Blake-Robotics/PiUPS/hardware/RPi_Hat.png

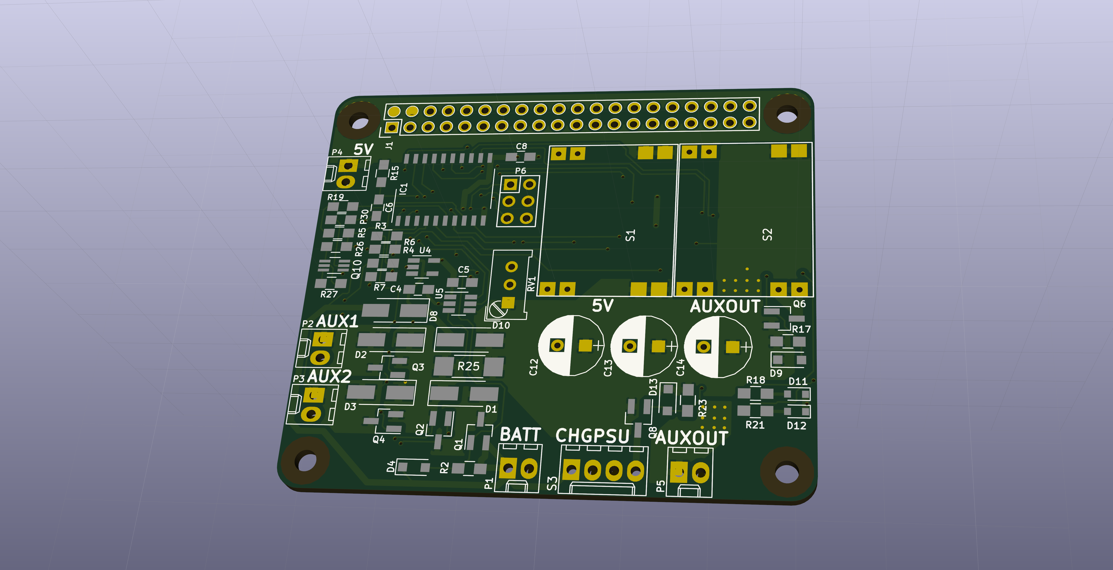
hardware/RPi_Hat.png
