Blake-Robotics/PiUPS/README.md

# PiUPS
Project to manage the power supply for the electronics of the robot. A microcontroller is used to monitor the state of the battery and external power inputs.
