Blake-Robotics/PiUPS/hardware/RPi_Hat.pdf

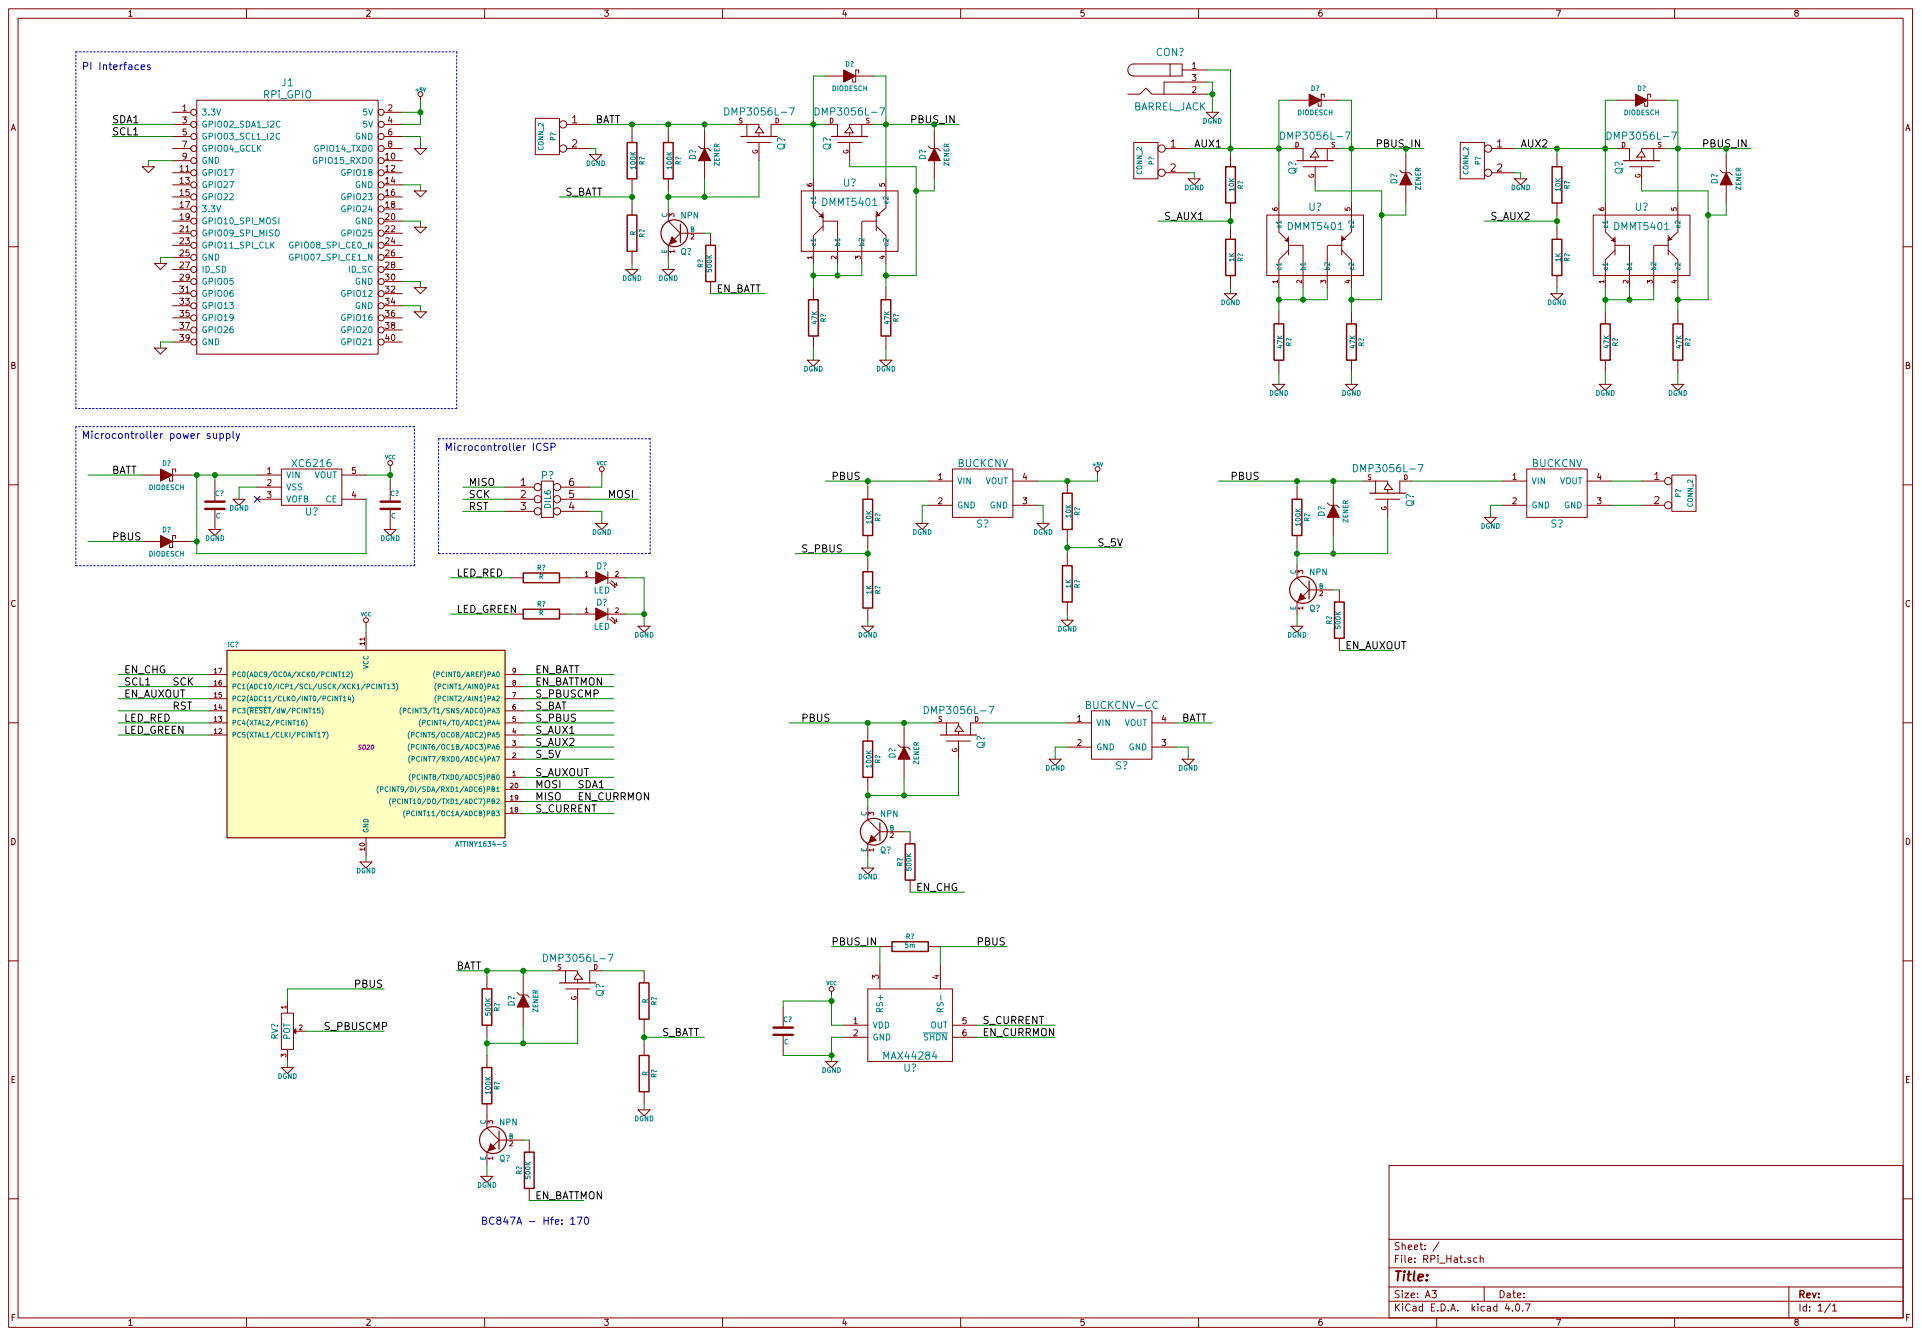
[picture p2: page 1]
