Blake-Robotics/PiUPS/hardware/RPi_Hat.kicad_pcb

## KiCad design hardware/RPi_Hat.kicad_pcb (2018-01-17)

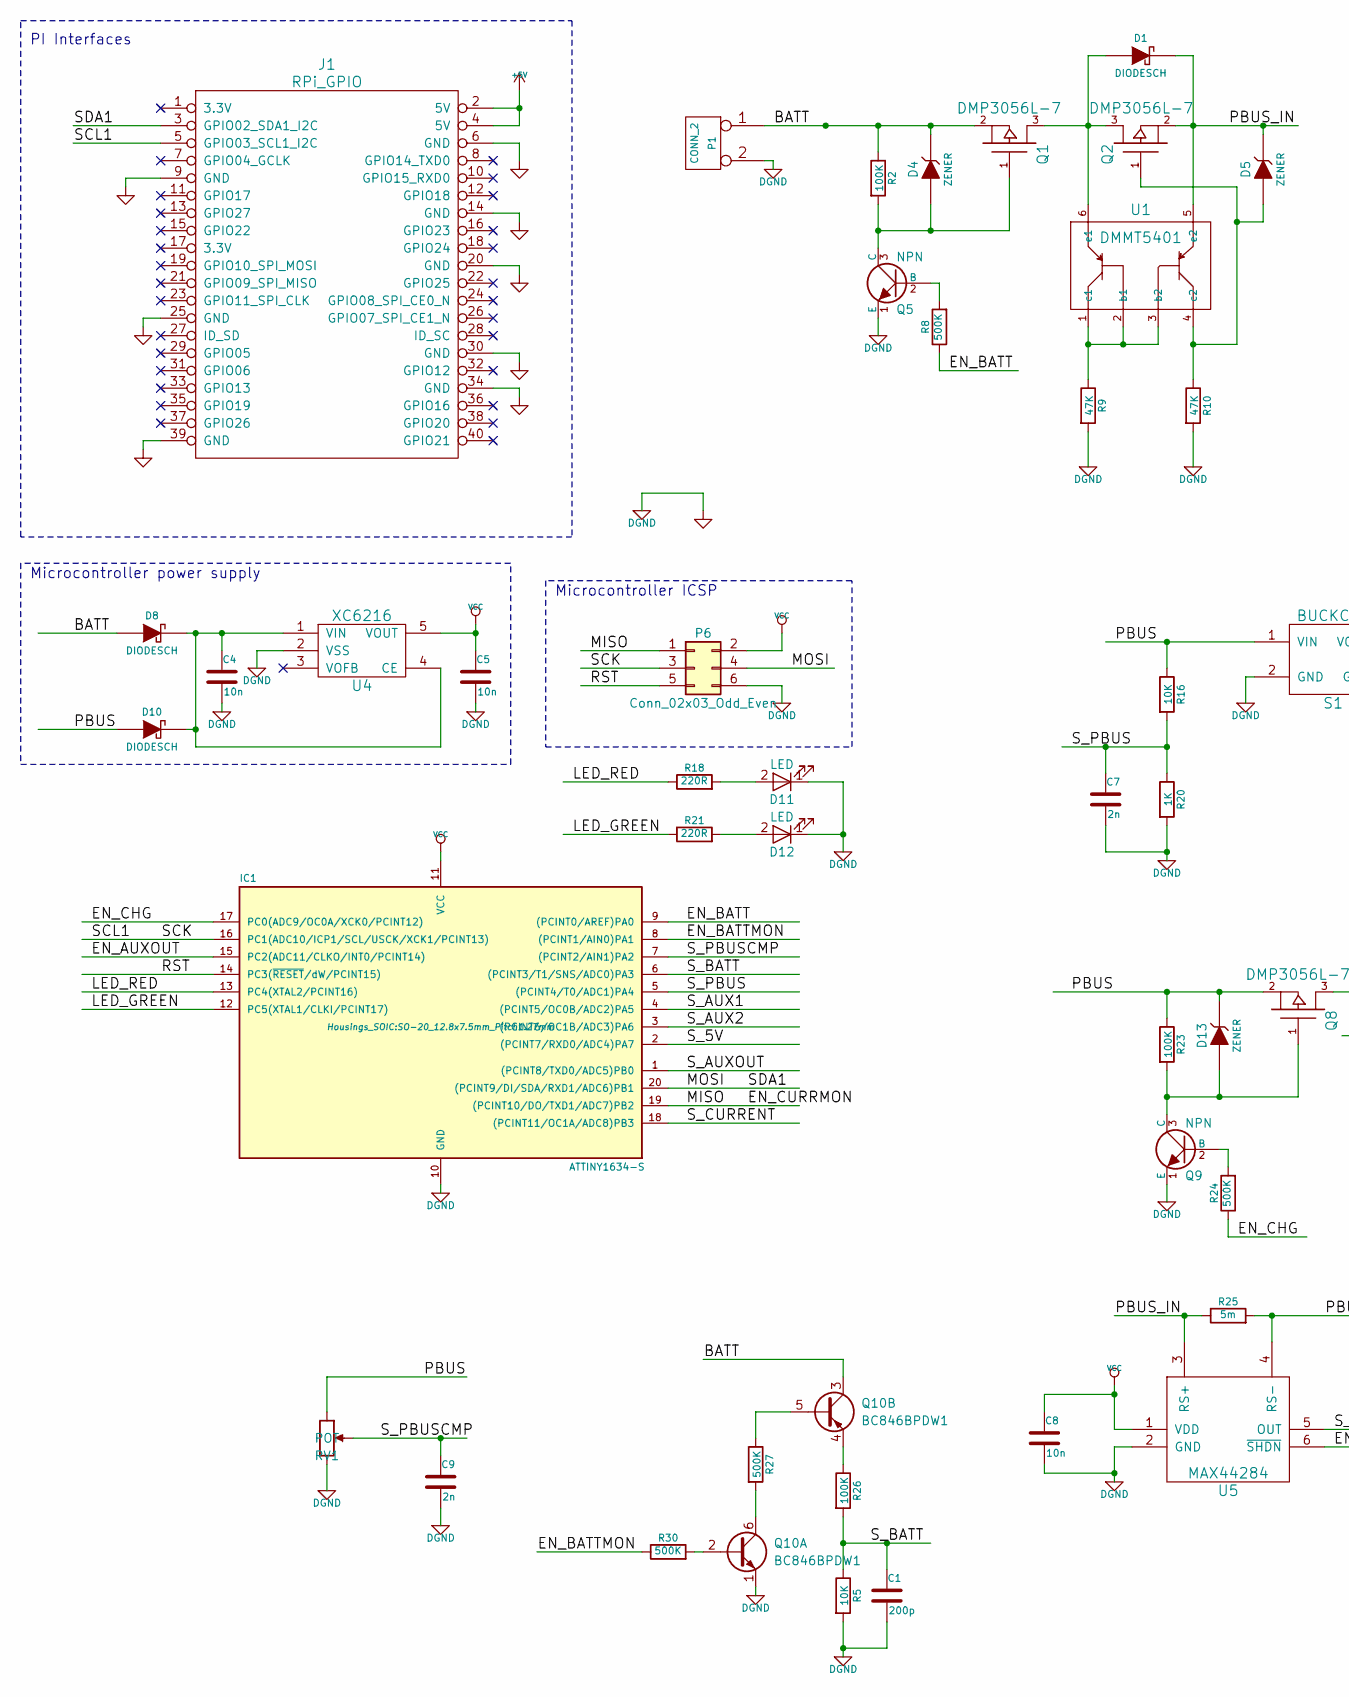
[picture p3: schematic RPi_Hat.sch, part in row 1, column 1]

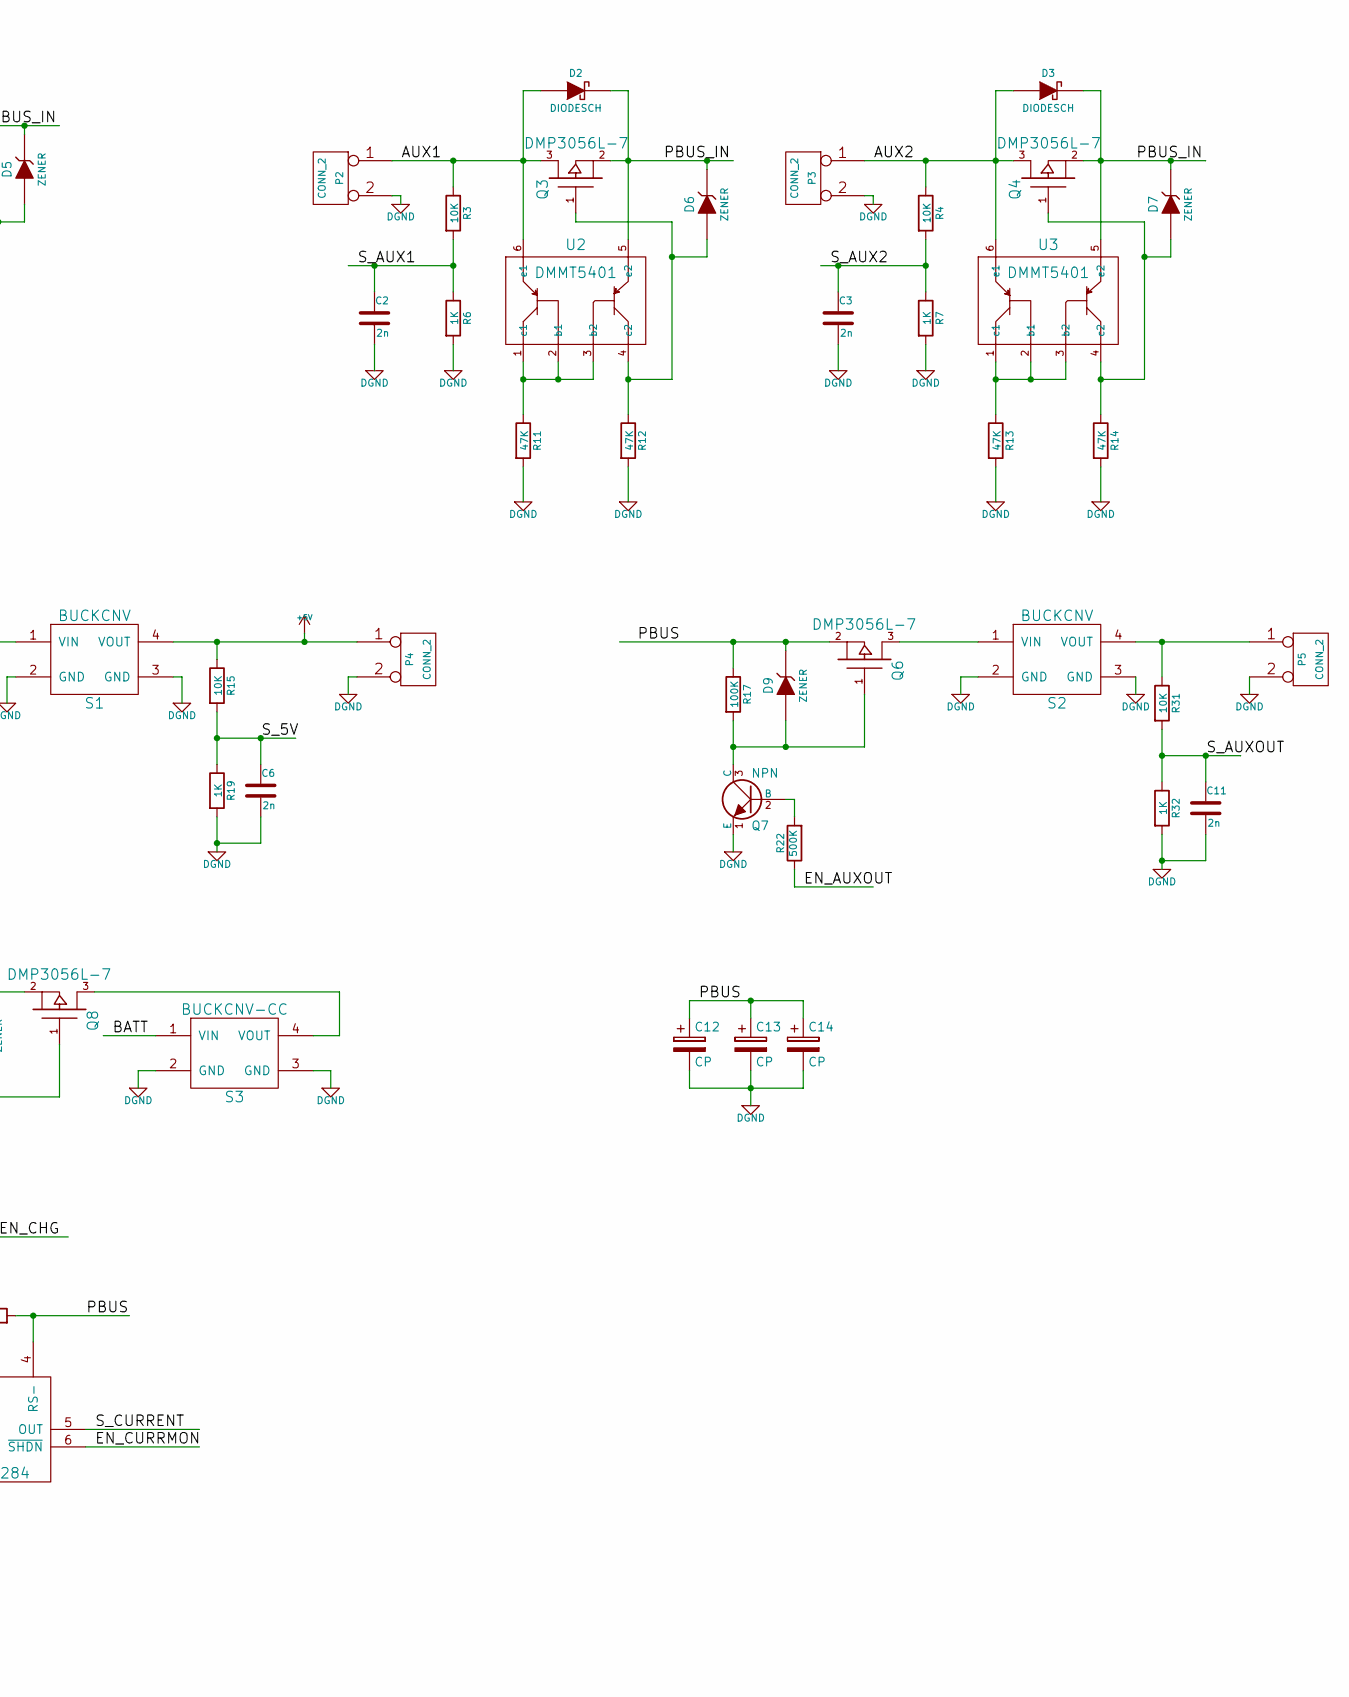
[picture p4: schematic RPi_Hat.sch, part in row 1, column 2]

Parts:
C1: 200p; C_0805_HandSoldering
C2, C3, C6, C7, C9, C11: 2n; C_0805_HandSoldering
C4, C5, C8: 10n; C_0805_HandSoldering
C12, C13, C14: CP; CP_Radial_D8.0mm_P3.50mm
D1, D2, D3, D8, D10: DIODESCH; D_SMA_Handsoldering
D4, D5, D6, D7, D9, D13: ZENER; D_SOD-123F
D11, D12: LED; D_0805
IC1: ATTINY1634-S; SO-20_12.8x7.5mm_Pitch1.27mm
J1: RPi_GPIO
P1, P2, P3, P4, P5: CONN_2; Molex_KK-6410-02_02x2.54mm_Straight
P6: Conn_02x03_Odd_Even; Header_2x03
Q1, Q2, Q3, Q4, Q6, Q8: DMP3056L-7; SOT-23_Handsoldering
Q5, Q7, Q9: NPN; SOT-23_Handsoldering
Q10: BC846BPDW1; SOT-363_SC-70-6_Handsoldering
R2, R17, R23, R26: 100K; R_0805_HandSoldering
R3, R4, R5, R15, R16, R31: 10K; R_0805_HandSoldering
R6, R7, R19, R20, R32: 1K; R_0805_HandSoldering
R8, R22, R24, R27, R30: 500K; R_0805_HandSoldering
R9, R10, R11, R12, R13, R14: 47K; R_0805_HandSoldering
R18, R21: 220R; R_0805_HandSoldering
R25: 5m; R_0805_HandSoldering
RV1: POT; Potentiometer_Trimmer_Bourns_PV36W
S1, S2: BUCKCNV; BUCK
S3: BUCKCNV-CC; Molex_KK-6410-04_04x2.54mm_Straight
U1, U2, U3: DMMT5401; SOT-23-6_Handsoldering
U4: XC6216; SOT-23-5_HandSoldering
U5: MAX44284; SOT-23-6_Handsoldering

Connections:
+5V: J1.2 (5V), J1.4 (5V), P4.1, R15.1, S1.4 (VOUT)
/AUX1: D2.2 (A), P2.1, Q3.3 (D), R3.1, U2.6 (e1)
/AUX2: D3.2 (A), P3.1, Q4.3 (D), R4.1, U3.6 (e1)
/BATT: D4.1 (K), D8.2 (A), P1.1, Q1.2 (S), Q10.3 (C2), R2.1, S3.1 (VIN)
/EN_AUXOUT: IC1.15 (PC2(ADC11/CLKO/INT0/PCINT14)), R22.1
/EN_BATT: IC1.9 ((PCINT0/AREF)PA0), R8.1
/EN_BATTMON: IC1.8 ((PCINT1/AIN0)PA1), R30.1
/EN_CHG: IC1.17 (PC0(ADC9/OC0A/XCK0/PCINT12)), R24.1
/EN_CURRMON: IC1.19 ((PCINT10/DO/TXD1/ADC7)PB2), P6.1, U5.6 (~SHDN)
/LED_GREEN: IC1.12 (PC5(XTAL1/CLKI/PCINT17)), R21.1
/LED_RED: IC1.13 (PC4(XTAL2/PCINT16)), R18.1
/MOSI: IC1.20 ((PCINT9/DI/SDA/RXD1/ADC6)PB1), J1.3 (GPIO02_SDA1_I2C), P6.4
/PBUS: C12.1, C13.1, C14.1, D9.1 (K), D10.2 (A), D13.1 (K), Q6.2 (S), Q8.2 (S), R16.1, R17.1, R23.1, R25.2, RV1.1, S1.1 (VIN), U5.4 (RS-)
/PBUS_IN: D1.1 (K), D2.1 (K), D3.1 (K), D5.1 (K), D6.1 (K), D7.1 (K), Q2.2 (S), Q3.2 (S), Q4.2 (S), R25.1, U1.5 (e2), U2.5 (e2), U3.5 (e2), U5.3 (RS+)
/RST: IC1.14 (PC3(~RESET~/dW/PCINT15)), P6.5
/SCK: IC1.16 (PC1(ADC10/ICP1/SCL/USCK/XCK1/PCINT13)), J1.5 (GPIO03_SCL1_I2C), P6.3
/S_5V: C6.1, IC1.2 ((PCINT7/RXD0/ADC4)PA7), R15.2, R19.1
/S_AUX1: C2.1, IC1.4 ((PCINT5/OC0B/ADC2)PA5), R3.2, R6.1
/S_AUX2: C3.1, IC1.3 ((PCINT6/OC1B/ADC3)PA6), R4.2, R7.1
/S_AUXOUT: C11.1, IC1.1 ((PCINT8/TXD0/ADC5)PB0), R31.2, R32.1
/S_BATT: C1.1, IC1.6 ((PCINT3/T1/SNS/ADC0)PA3), R5.1, R26.2
/S_CURRENT: IC1.18 ((PCINT11/OC1A/ADC8)PB3), U5.5 (OUT)
/S_PBUS: C7.1, IC1.5 ((PCINT4/T0/ADC1)PA4), R16.2, R20.1
/S_PBUSCMP: C9.1, IC1.7 ((PCINT2/AIN1)PA2), RV1.2
DGND: C1.2, C2.2, C3.2, C4.2, C5.2, C6.2, C7.2, C8.2, C9.2, C11.2, C12.2, C13.2, C14.2, D11.1 (K), D12.1 (K), IC1.10 (GND), J1.6 (GND), J1.9 (GND), J1.14 (GND), J1.20 (GND), J1.25 (GND), J1.30 (GND), J1.34 (GND), J1.39 (GND), P1.2 (PM), P2.2 (PM), P3.2 (PM), P4.2 (PM), P5.2 (PM), P6.6, Q5.1 (E), Q7.1 (E), Q9.1 (E), Q10.1 (E1), R5.2, R6.2, R7.2, R9.2, R10.2, R11.2, R12.2, R13.2, R14.2, R19.2, R20.2, R32.2, RV1.3, S1.2 (GND), S1.3 (GND), S2.2 (GND), S2.3 (GND), S3.2 (GND), S3.3 (GND), U4.2 (VSS), U5.2 (GND)
unnamed: C4.1, D8.1 (K), D10.1 (K), U4.1 (VIN), U4.4 (CE)
unnamed: D1.2 (A), Q1.3 (D), Q2.3 (D), U1.6 (e1)
unnamed: D4.2 (A), Q1.1 (G), Q5.3 (C), R2.2
unnamed: D5.2 (A), Q2.1 (G), R10.1, U1.4 (c2)
unnamed: D6.2 (A), Q3.1 (G), R12.1, U2.4 (c2)
unnamed: D7.2 (A), Q4.1 (G), R14.1, U3.4 (c2)
unnamed: D9.2 (A), Q6.1 (G), Q7.3 (C), R17.2
unnamed: D11.2 (A), R18.2
unnamed: D12.2 (A), R21.2
unnamed: D13.2 (A), Q8.1 (G), Q9.3 (C), R23.2
unnamed: P5.1, R31.1, S2.4 (VOUT)
unnamed: Q5.2 (B), R8.2
unnamed: Q6.3 (D), S2.1 (VIN)
unnamed: Q7.2 (B), R22.2
unnamed: Q8.3 (D), S3.4 (VOUT)
unnamed: Q9.2 (B), R24.2
unnamed: Q10.2 (B1), R30.2
unnamed: Q10.4 (E2), R26.1
unnamed: Q10.5 (B2), R27.1
unnamed: Q10.6 (C1), R27.2
unnamed: R9.1, U1.1 (c1), U1.2 (b1), U1.3 (b2)
unnamed: R11.1, U2.1 (c1), U2.2 (b1), U2.3 (b2)
unnamed: R13.1, U3.1 (c1), U3.2 (b1), U3.3 (b2)
VCC: C5.1, C8.1, IC1.11 (VCC), P6.2, U4.5 (VOUT), U5.1 (VDD)

Notes on the sheet:
Microcontroller power supply
Microcontroller ICSP
PI Interfaces

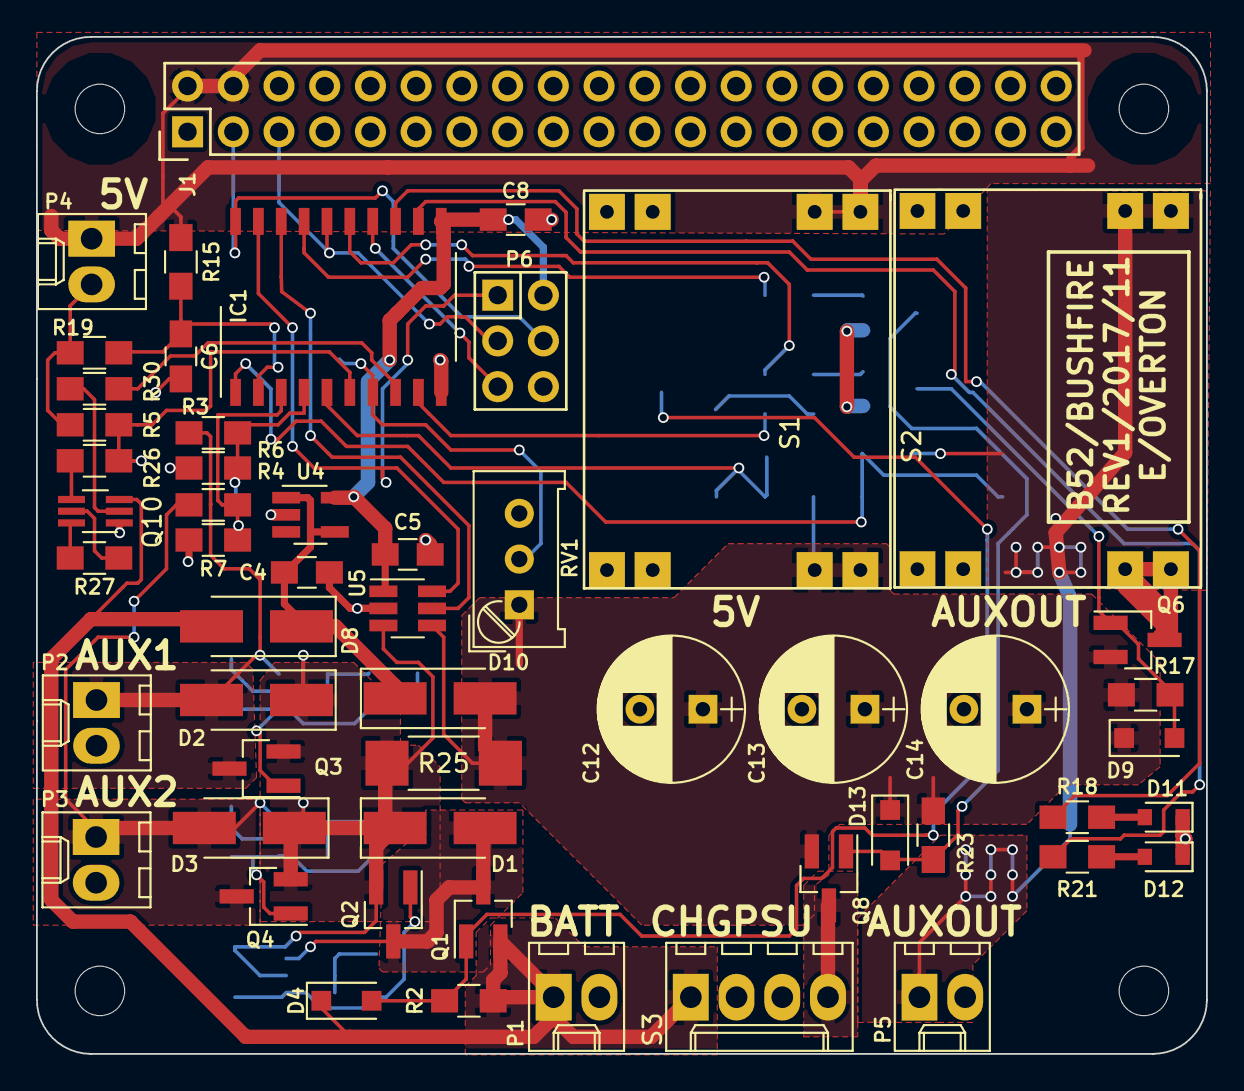
[picture p5: board RPi_Hat.kicad_pcb from above]

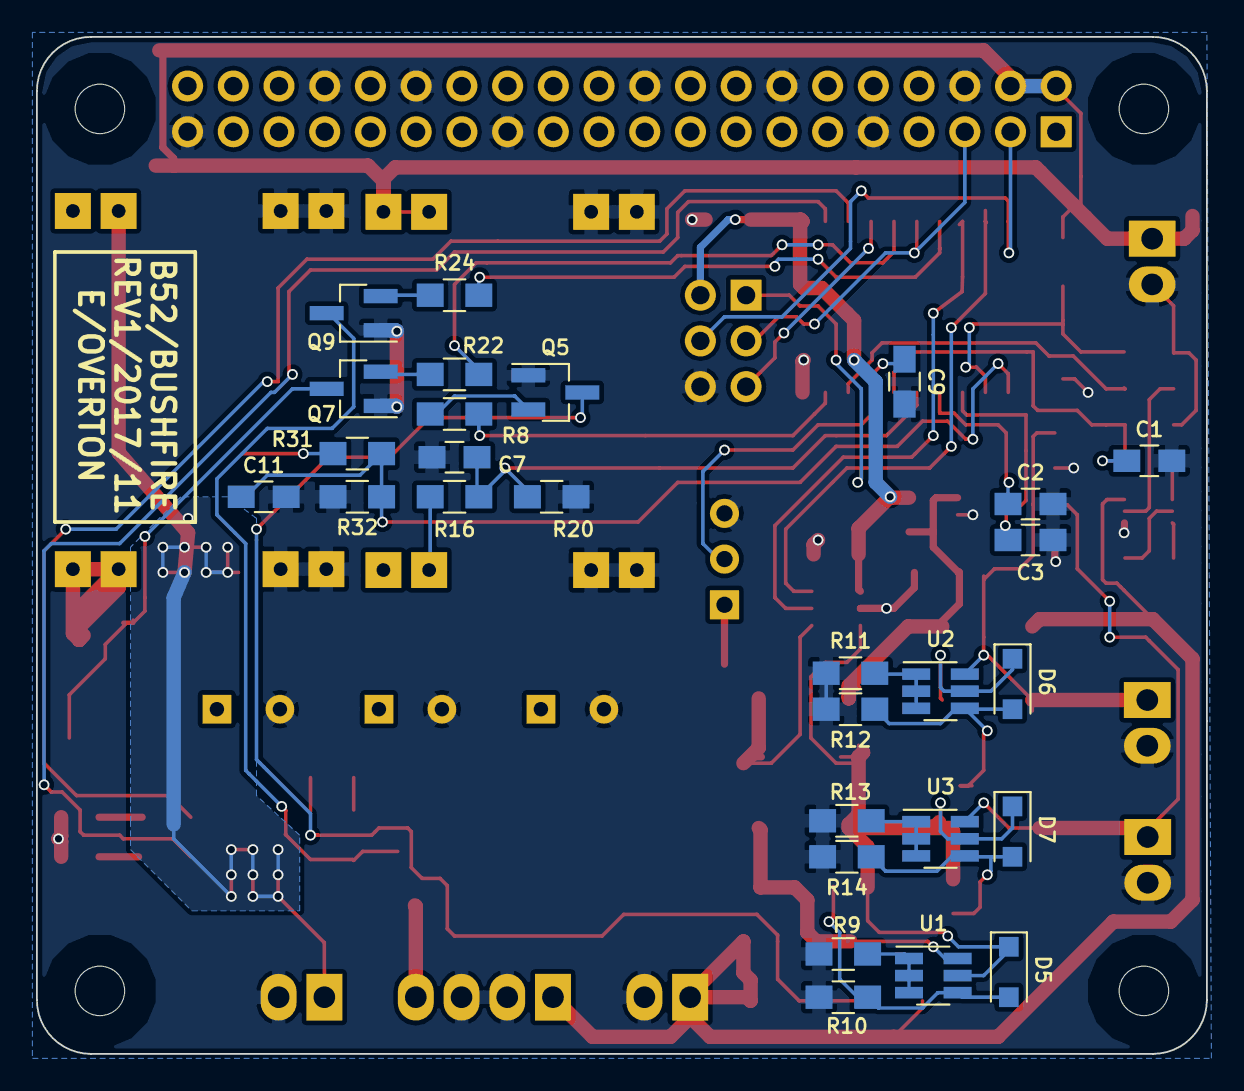
[picture p6: board RPi_Hat.kicad_pcb from below]

Board: 2 copper layers, 65.0 x 56.5 mm, 82 parts (28 on the bottom side), 49 nets.
