Blake-Robotics/PiUPS/(commit log)

2017-09-15 Extended ADC to cover all channels, and now load resistor divider values from the eeprom, which can be set over i2c.
2017-09-15 Initial commit of some software for communicating with the microcontroller over I2C on the PI
2017-09-19 Added current status to return power source
2017-09-19 Split I2C access to seperate tools, which need integrating with make and testing
2017-09-21 Updates to add i2ctools to makefile, and to use them in i2ctest
2017-10-22 Adding 5V rail voltage sensor
2017-10-28 Extended software to read 5v rail
2017-10-31 Beginning schematic to make a hat
    [RPi_Hat.kicad_pcb, RPi_Hat.sch]
2017-11-02 Almost finished schematic
    [RPi_Hat.sch]
2017-11-12 Semi finished pcb
    [RPi_Hat.kicad_pcb, RPi_Hat.sch]
2017-11-15 First PCB version
    [RPi_Hat.kicad_pcb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]
2017-11-15 Added solder masks to gerbers
    [RPi_Hat-B.Cu.gbr, RPi_Hat-B.Mask.gbr, RPi_Hat-B.SilkS.gbr, RPi_Hat-Edge.Cuts.gbr, RPi_Hat-F.Cu.gbr, RPi_Hat-F.Mask.gbr, RPi_Hat-F.SilkS.gbr]
2017-11-17 BOM Updates for Rev1
    [RPi_Hat.csv, RPi_Hat.sch]
2017-11-26 Support for extra sensors
2017-12-06 Extensions to I2C registers
2017-12-06 Extended registers and fixed bug in power source detection
    [PiUPSDefines.h, eeprom.h, main.c]
2017-12-07 Added power saving to program
2018-01-17 Fix to enable battery charging in firmware
    [RPi_Hat.csv, RPi_Hat.kicad_pcb]
